rouderaa/lamidi/3ddesign/lamidi-fullbracket002.stl

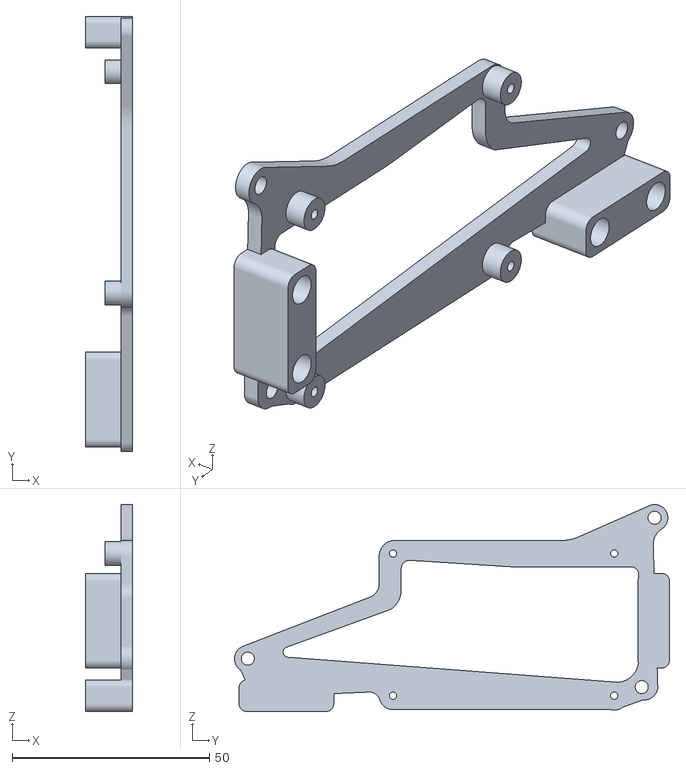
[picture p3: CAD file, 2025-08-22]
3ddesign/lamidi-fullbracket002.stl
12.0 x 110.1 x 52.4
