rouderaa/lamidi/3ddesign/lamidi.FCStd

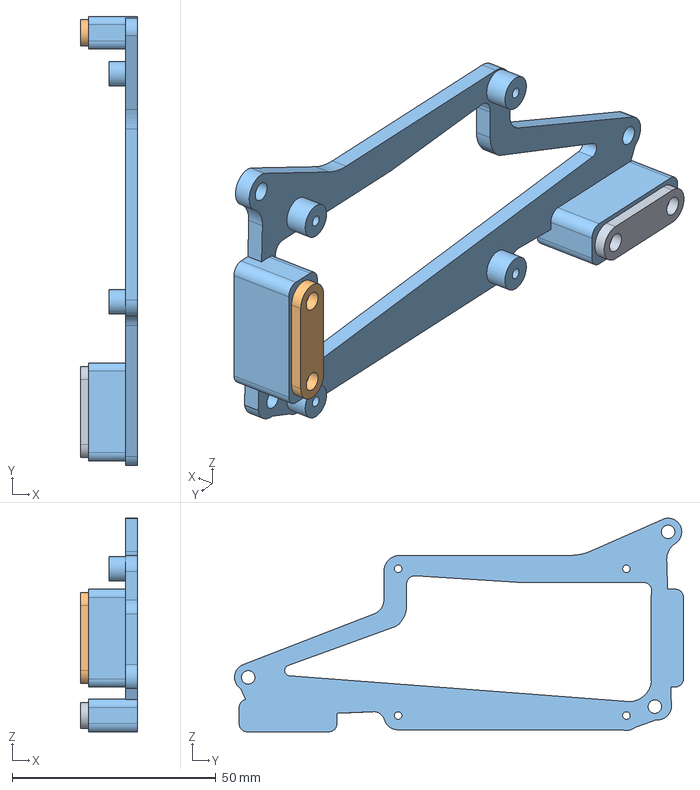
[picture p4: CAD file, 2025-08-22]
3ddesign/lamidi.FCStd
14.0 x 110.1 x 52.4 mm
tieLidExtrude001
tieLidExtrude002
fullbracket002
