rouderaa/lamidi/3ddesign/lamidi-tieLidExtrude002.stl

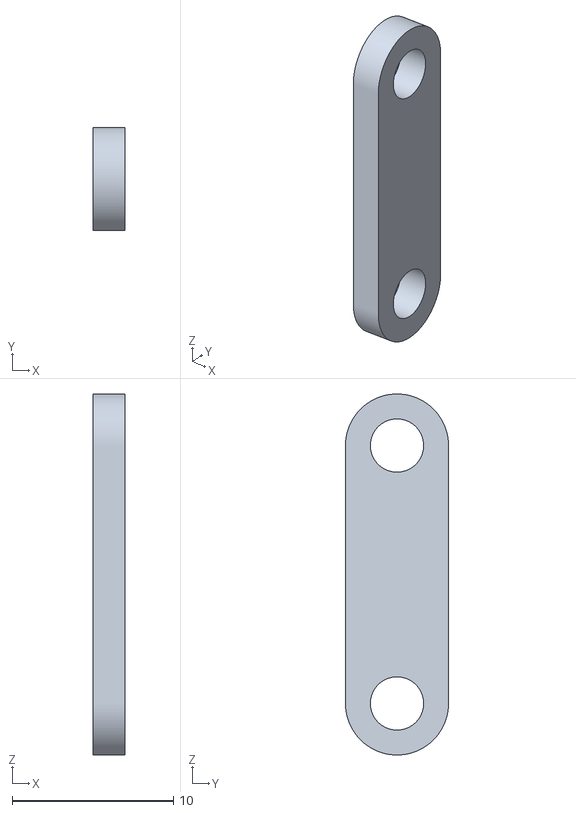
[picture p5: CAD file, 2025-08-22]
3ddesign/lamidi-tieLidExtrude002.stl
2.00 x 6.39 x 22.4
