rouderaa/lamidi/(list of files, cad)

Other CAD files:
3ddesign/lamidi-tieLidExtrude001.stl
