rouderaa/lamidi/schematic/lamidi.pdf

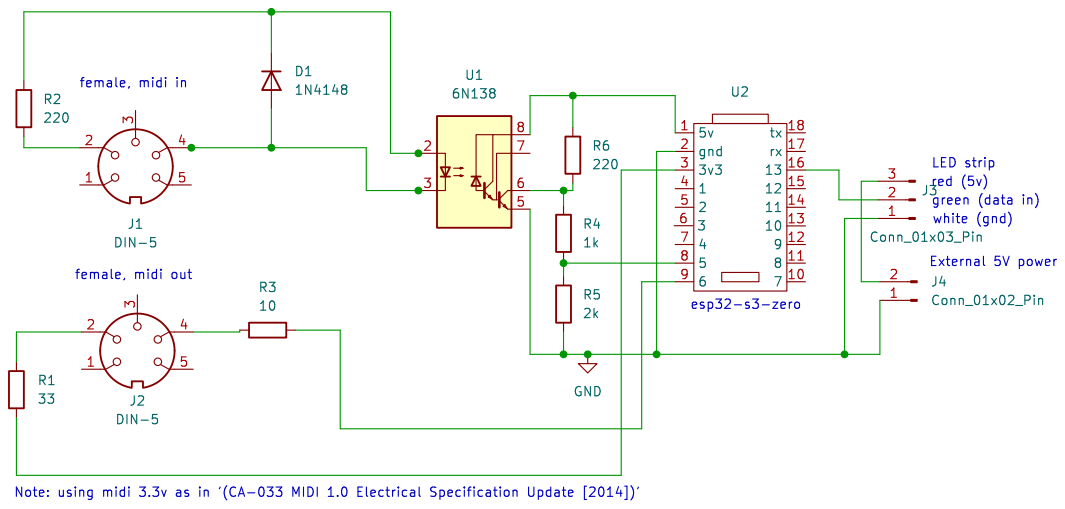
[picture p6: page 1]

Id: 1/1 Title: File: lamidi.kicad_sch Sheet: /
