rouderaa/lamidi/schematic/lamidi.kicad_sch

## KiCad design schematic/lamidi.kicad_sch (2025-08-22)

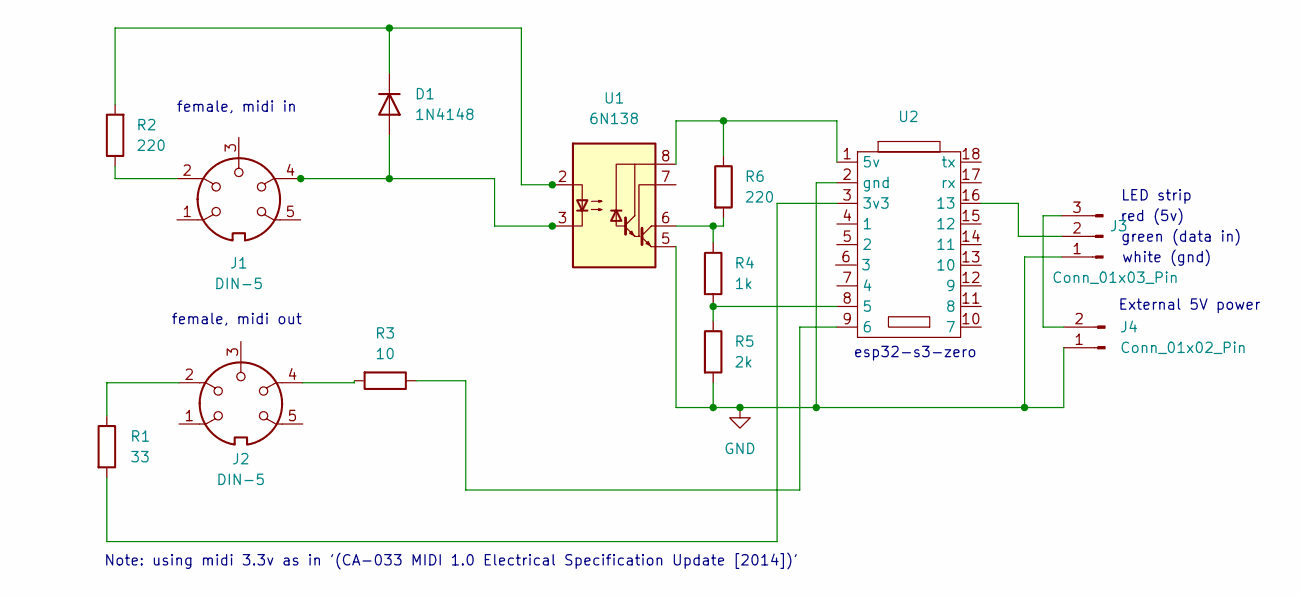
[picture p7: schematic lamidi.kicad_sch]

Parts:
D1: 1N4148; D_DO-35_SOD27_P7.62mm_Horizontal
J1, J2: DIN-5
J3: Conn_01x03_Pin
J4: Conn_01x02_Pin
R1: 33
R2, R6: 220
R3: 10
R4: 1k
R5: 2k
U1: 6N138
U2: (no value)

Connections:
GND: J3.1, J4.1, R5.2, U1.5 (GND), U2.2 (gnd)
unnamed: D1.1 (K), R2.2, U1.2 (C1)
unnamed: D1.2 (A), J1.4, U1.3 (C2)
unnamed: J1.2, R2.1
unnamed: J2.2, R1.1
unnamed: J2.4, R3.2
unnamed: J3.2, U2.16 (13)
unnamed: J3.3, J4.2
unnamed: R1.2, U2.3 (3v3)
unnamed: R3.1, U2.9 (6)
unnamed: R4.1, R6.2, U1.6 (VO2)
unnamed: R4.2, R5.1, U2.8 (5)
unnamed: R6.1, U1.8 (VCC), U2.1 (5v)

Notes on the sheet:
red (5v)
Note: using midi 3.3v as in '(CA-033 MIDI 1.0 Electrical Specification Update [2014])'
esp32-s3-zero
female, midi in
green (data in)
white (gnd)
female, midi out
LED strip
External 5V power
